IlliniGRC/GestureRobotController/README.pdf

README.md | 2/9/2022

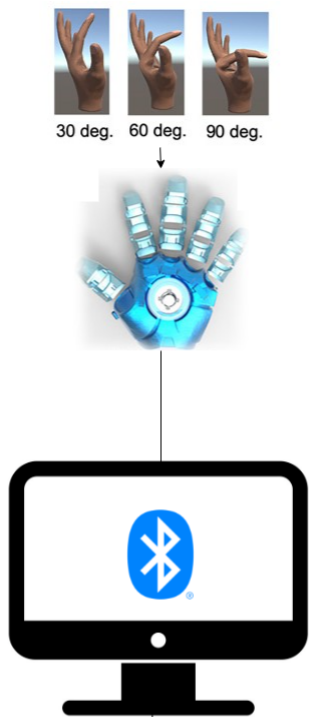
[picture p40: figure]

/

# Gesture Robot Controller

## Project proposal

Team Member: Eric Zhou, Guang Yin, Haoduo Yan

TA: Hanyin Shao

## Problem

Traditionally, different robots are controlled by their specialized controller from different companies, and it takes time to learn how to smoothly and naturally use them. We propose a gesture control system that builds upon the system, making the process of controlling a robot simple and fun.

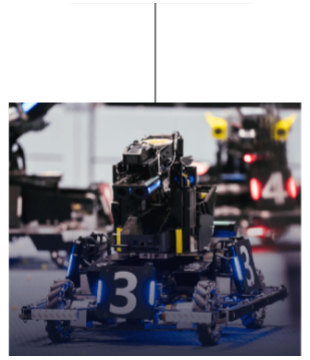
[picture p41: figure]

Solution

We plan to design a robot controller which can recognize human gestures and send corresponding commands to robots. The system will have three high-level requirements.

The first one is that the controller mounted on the user would be able to read the sensors placed on the body of the user and calculate the position of different body parts of the user and broadcast through Bluetooth.

The second one is that it would enable the gestures and movements of the user to be translated to actual robot controlling actions through a software running on a powerful device (like PC) after receiving data using Bluetooth, and it would also have the capability of commanding the robot using another Bluetooth link.

The third one is that it would be able to transmit the warnings of robots to signals that can be sensed by humans through actuators placed on the user, like lights (LEDs), vibration motors, and buzzers.

## Design

Block Diagram

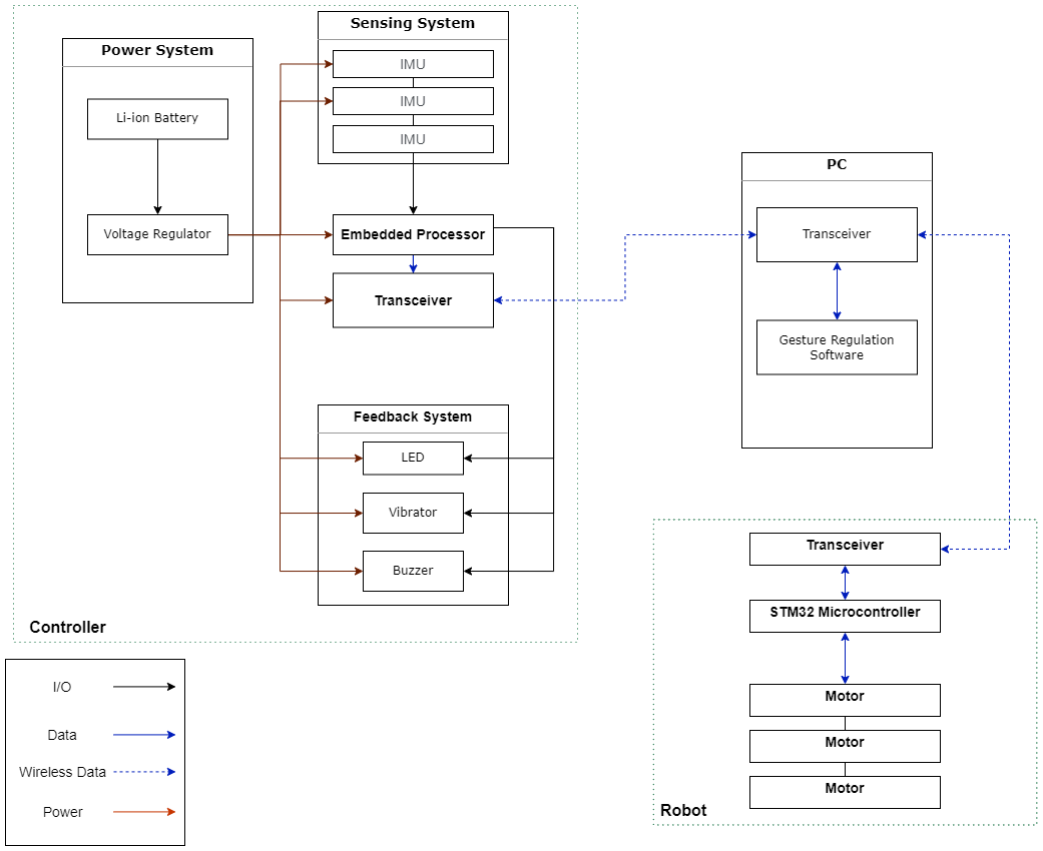
[picture p42: figure]

Subsystem Overview

Human Positioning System

The system consists of a power source, an embedded processor, multiple IMUs, and a transceiver. Firstly, the IMUs are placed on the user's body, and the user will input the locations of these sensors to the embedded processor. The embedded processor will constantly read data from the IMUs using the I2C protocol, then it will calculate the position of these IMUs in the space. Together with the user predefined IMU position, it will work out the positions and orientations of the user's body parts. After that, the transceiver will output these raw data to PC through a 2.45GHz Bluetooth data-link.

Gesture Control System

The system would be a software program resides on the PC. It will take in the raw data transferred by the transceiver of the Human Positioning System and detect gestures using those data. Ideally, it can recognize many gestures such as the motion of and leg, including making a fist, waving arms, shaking head, etc., depending on the positions of the IMUs placed on the user. Then the system will generate controls based on these gestures and send them to the robot using another 2.45GHz Bluetooth data-link.

Robot Feedback System

The system would be a program resides on both PC and embedded processor of the controller. It will be used to transfer some signals generated by the robot back to the user through the actuators placed on the user. It will also use the same 2.45GHz Bluetooth data-link that the controller used to communicate with PC, sending the signals to trigger vibration motors, LEDs, and buzzers on the controller.

Subsystem Requirements

Human Positioning System

It should be able to read the data from 9-axis IMUs through IIC protocol.
It should be able to translate the readings into angles or other easy-to-understandable parameters It can transmit the results of calculation to PC or robot controller for them to interpret the data.

Gesture Control System

It should be able to recognize at least the gestures of users listed below

Making a fist to stop the robot from moving
Extend the fingers, then the robot will move in a direction where the user's palm is directed to.

It would be able to translate these predefined gestures to robot movements.

It can transmit the corresponding robot commands to the robot using a Bluetooth data-link.

Robot Feedback System

It should be able to receive signals sent from PC or controller on the robot.

It should be able to interpret the feedback signals from the robot and control the following devices mounted on the user.

LED (array) blinking
Buzzer play predefined sound sequence Vibration motor turning

Tolerance Analysis

The IMUs will be measuring the magnetic field strength to calculate the angle of the unit. However, if the IMU is placed near a powerful external magnetic field source other than the earth (e.g. motors, large block of conductive metal, wall power cable/outlet), then the reading might be affected and produce garbage result.

## Ethics and Safety

User Safety

1. Since our product will directly contact human skin, it is important to separate the skin from electricity and make sure that no hazardous components will put users in danger.
2. When power is low, the product should notify the user and shut down the system automatically to prevent the battery from starvation. If the system is not in use for a long time, it should also shut down by itself.

Build Safety

1. Always power off the battery before any hardware changes. Rubber gloves are required before touching any electric components.
