IlliniGRC/GestureRobotController/primary_controller/controller_main/main.py

import time
import driver.utils as utils

from functionality.board import Board
from functionality.wt901 import WT901
from functionality.communication import Communication as Com

def main():
  """ Main function, contains event loop """
  # auxiliary initializations
  Board.auxiliary_init()

  # waiting for peripheral controller to connect
  while True:
    Board.status_led.change_state(True)
    if Board.uart1_com.read_all(Com.BOOT_UP) != None:
      Board.status_led.change_state(False)
      break
    Board.uart1_com.send(Com.BOOT_UP, "")
    Board.status_led.change_state(False)
    time.sleep_ms(300)

  time.sleep_ms(300)
  Board.uart1_com.discard_all(Com.BOOT_UP)
  
  Board.event_loop()

if __name__ == '__main__':
  # !!! Do NOT modify this function !!!
  # allow REPL to run in parallel with main function
  utils.execute_main(main)
