IlliniGRC/GestureRobotController/primary_controller/controller_main/driver/utils.py

import os, machine
from functionality.board import Board
from driver.threading import Thread

# Timer IDs used by different utilities
UART_TIMER_ID = 0

def execute_main(func) -> None:
  """ Execute the main function, call all the main_init functions before running the main thread
      `start_screen`: whether the start screen animation is played"""
  # main initializations
  Board.main_init()

  # LED flash
  Board.status_led.show_bootup()

  # execute main
  main_thread = Thread(func)
  main_thread.run()


# Assertion -------------------------------------------------------------------

def EXPECT_TRUE(condition: bool, message: str) -> None:
  """ Expect condition to be true, generate a warning if violated, non-blocking """
  if not condition:
    print(f"Warning: {message}")
    Board.status_led.show_warning()
  
def ASSERT_TRUE(condition: bool, message: str) -> None:
  """ Assert condition to be true, generate an error if violated, blocking """
  if not condition:
    print(f"ERROR: {message}")
    Board.status_led.show_error()
  

# For REPL use ----------------------------------------------------------------

def remove_main_file() -> None:
  """ Remove the main file in case REPL not responding """
  os.remove("main.py")

def print_file(filename: str) -> None:
  """ Print given file to REPL
      `filename`: name of the file """
  with open(filename) as f:
    print(f.read())

def storage_status() -> None:
  """ Print current storage status to REPL """
  fs_bsize, fs_frsize, f_blocks, f_bfree, *_ = os.statvfs("/")
  print(f"Filesystem block size:        {fs_bsize} kB")
  print(f"Fragment size:                {fs_frsize} kB")
  print(f"Total size of Filesystem:     {f_blocks} blocks")
  print(f"Available size of Filesystem: {f_bfree} blocks") 
