IlliniGRC/GestureRobotController/(commit log)

2022-03-14 Eric worklog 2022FEB14 (#3)
    * readme update
    * UART read through python script
    * image placement method change
    * image placement method change again
    * quaternion to Euler formula & format change
    * header added & q2E wiki source added
    * new line at EOF
    * IIC com with two WT901 & operation env
    * rephase
2022-03-28 Eric worklog 2022MAR7 (#4)
    * CPU discussion
    * step up circuit
    * small change
    * auto program circuit
    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
2022-05-05 Controller Code (#6)
    * primary controller initial code
    * config draft & keyboard function update
    * text viewer functionality done
    * text viewer file
    * change snake game invoke method
    * change project name
    * menu doc string added
    * grammar & spelling fix
    * uart send
    * change iic name to i2c
    * main controller init code
    * delete old controller main file
    * buzzer added
    * snake & boot & PWM update
    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
    [bluetooth.py, board.py, boot.py, communication.py, config.py, display.py, io.py, main.py]
